pochihh/MAE_162_2026/mechanical/README.md

# Mechanical Design

CAD files for the robot chassis and manipulator systems.
