pochihh/MAE_162_2026/docs/README.md

# Documentation

Assembly instructions, course materials, and technical documentation.

## Contents

### Assembly Guides
- PCB assembly instructions
- Mechanical assembly steps
- Wiring diagrams and connection guides
- Initial setup and calibration procedures

### Course Materials
- Lab exercises and tutorials
- Programming examples
- Troubleshooting guides
- Theory and background materials

### Technical Documentation
- Hardware interface specifications
- Software API documentation
- Safety guidelines

## Format

Documents should be:
- Student-friendly with clear diagrams and photos
- Version-controlled (prefer Markdown when possible)
- Tested by having students follow instructions
