pochihh/MAE_162_2026/NUEVO board/schematic/SCH_Schematic1_2026-02-13.pdf

# Power Input

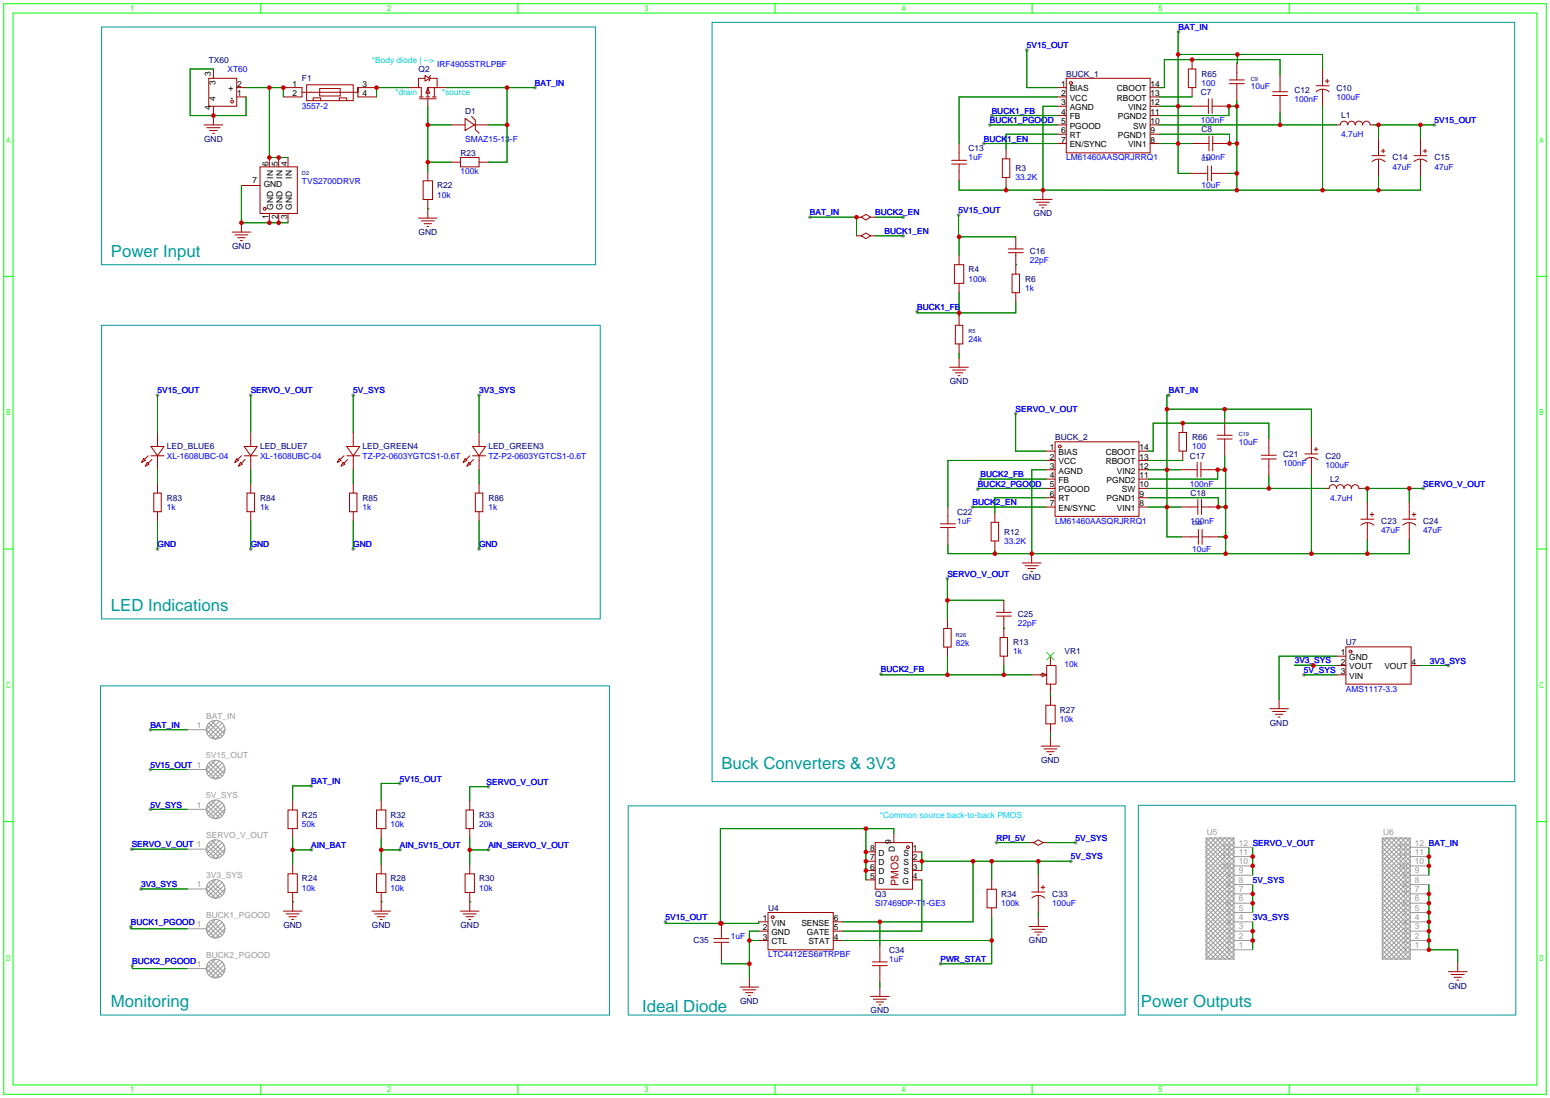
[picture p1: page 1]

*Common source back-to-back PMOS

Power Outputs Ideal Diode

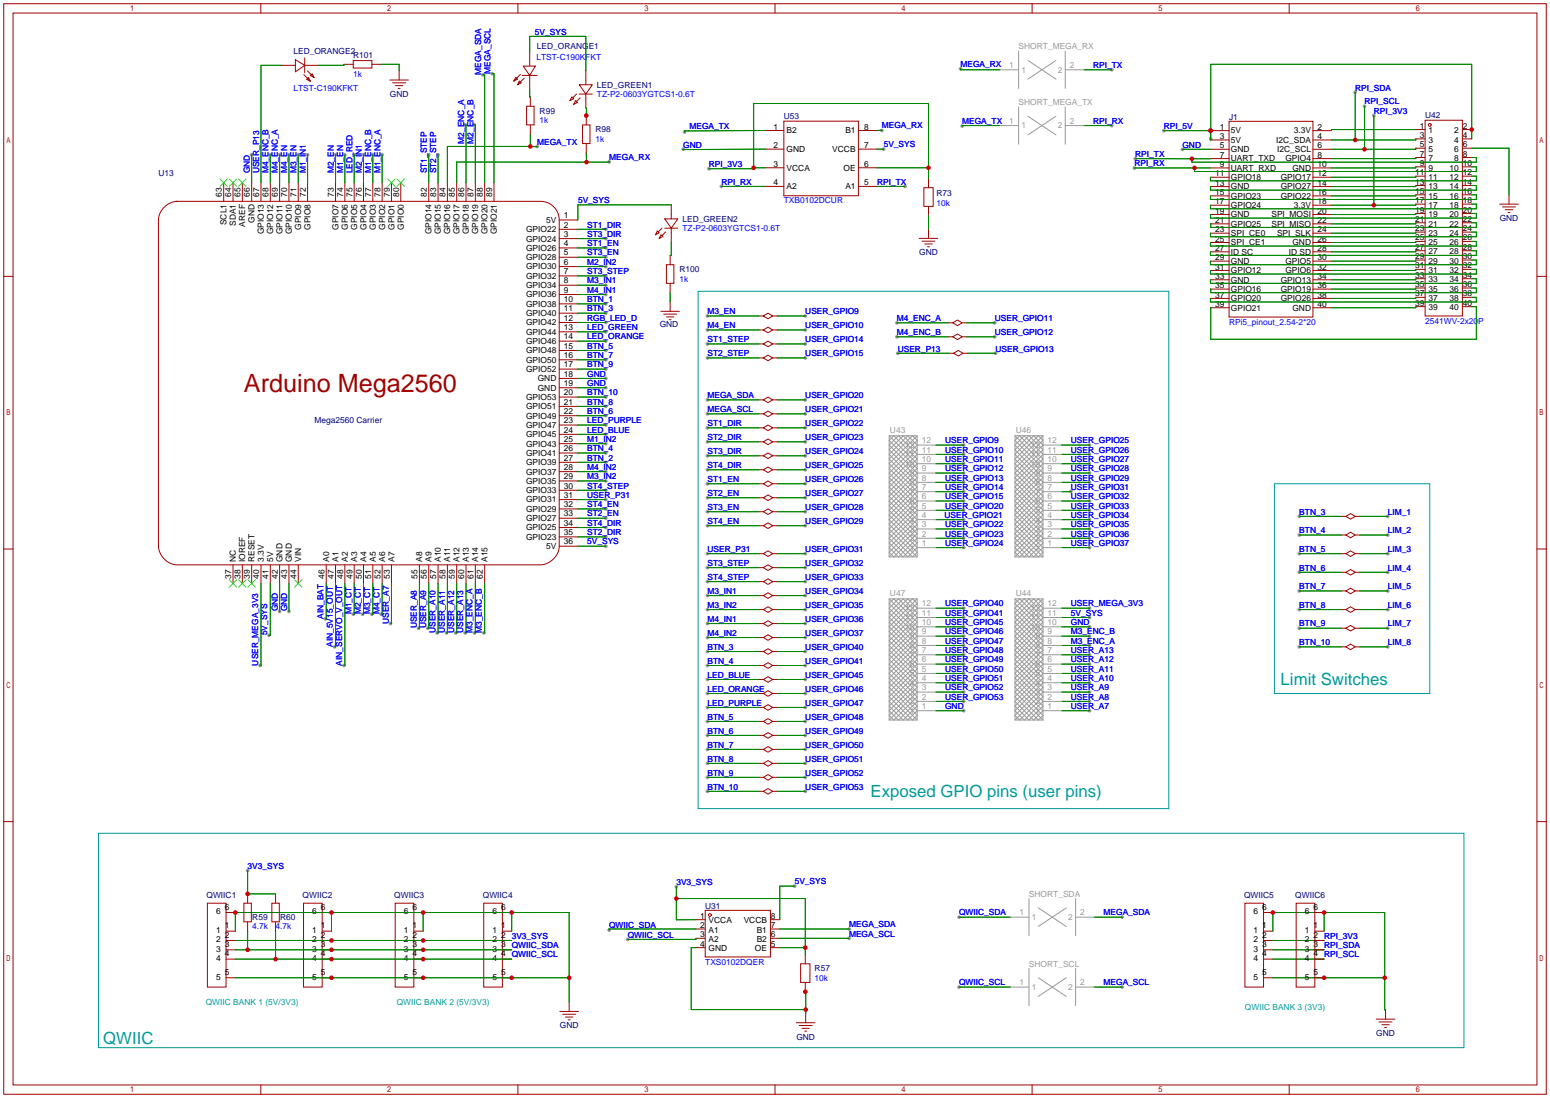
[picture p2: page 2]

Exposed GPIO pins (user pins)

# Dual H-Bridge

# Dual H-Bridge

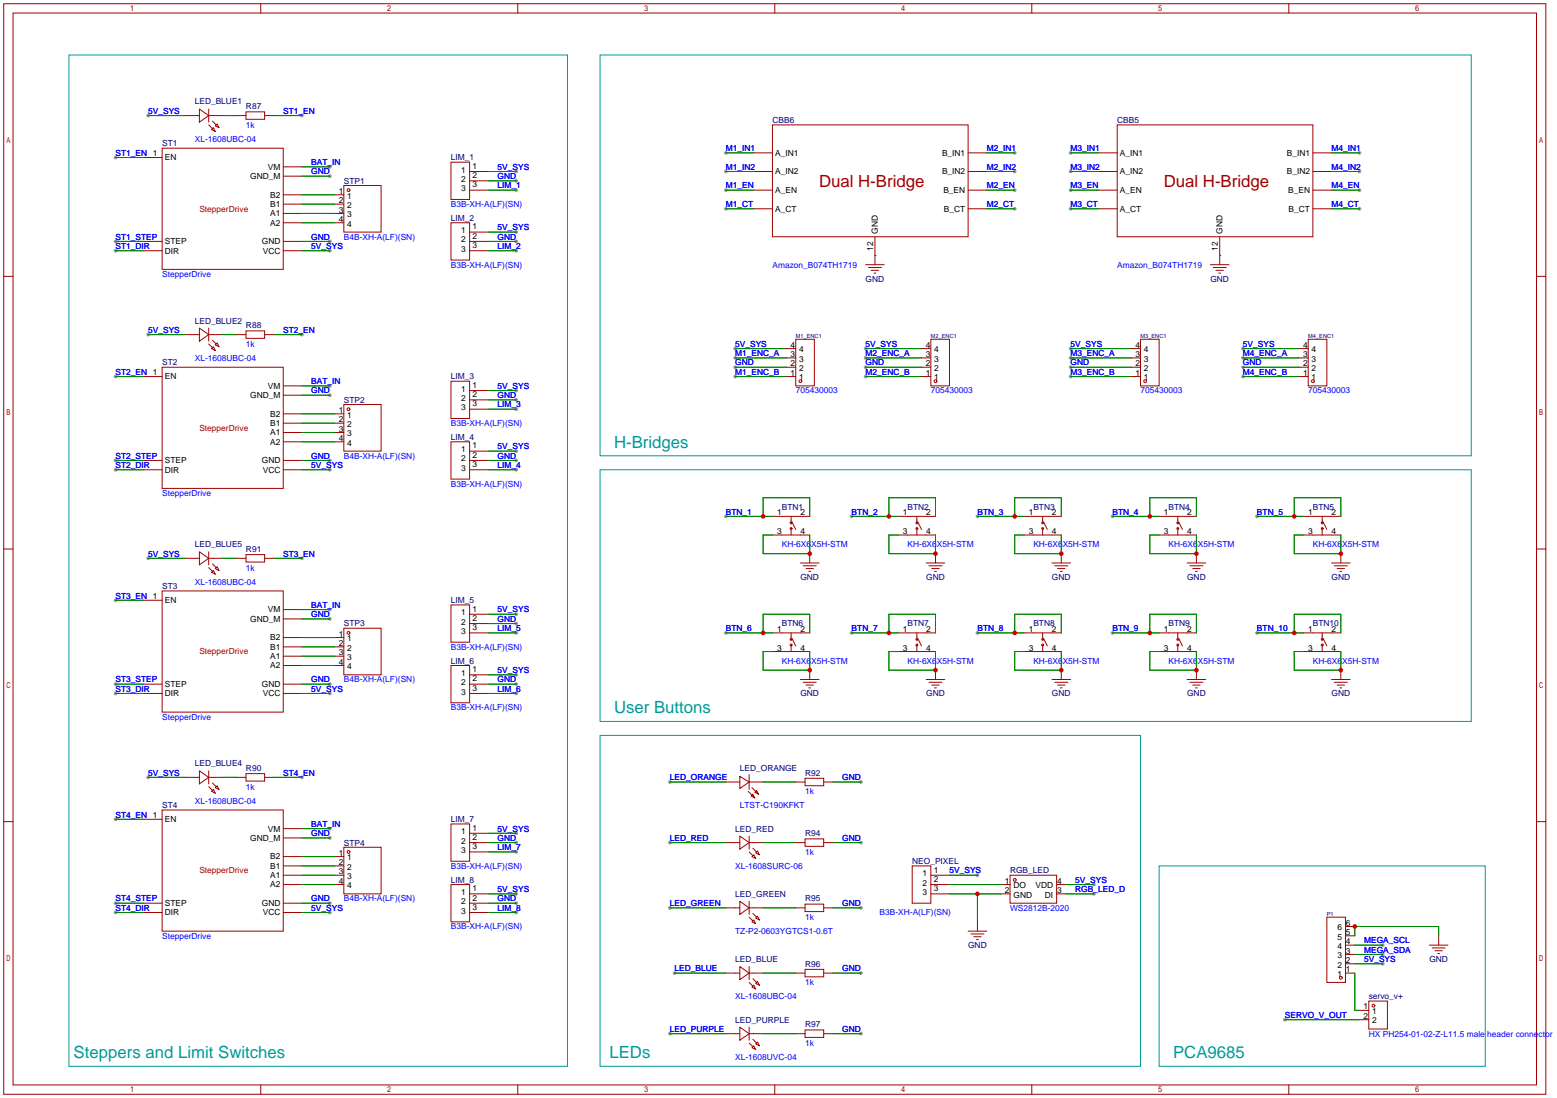
[picture p3: page 3]

Steppers and Limit Switches

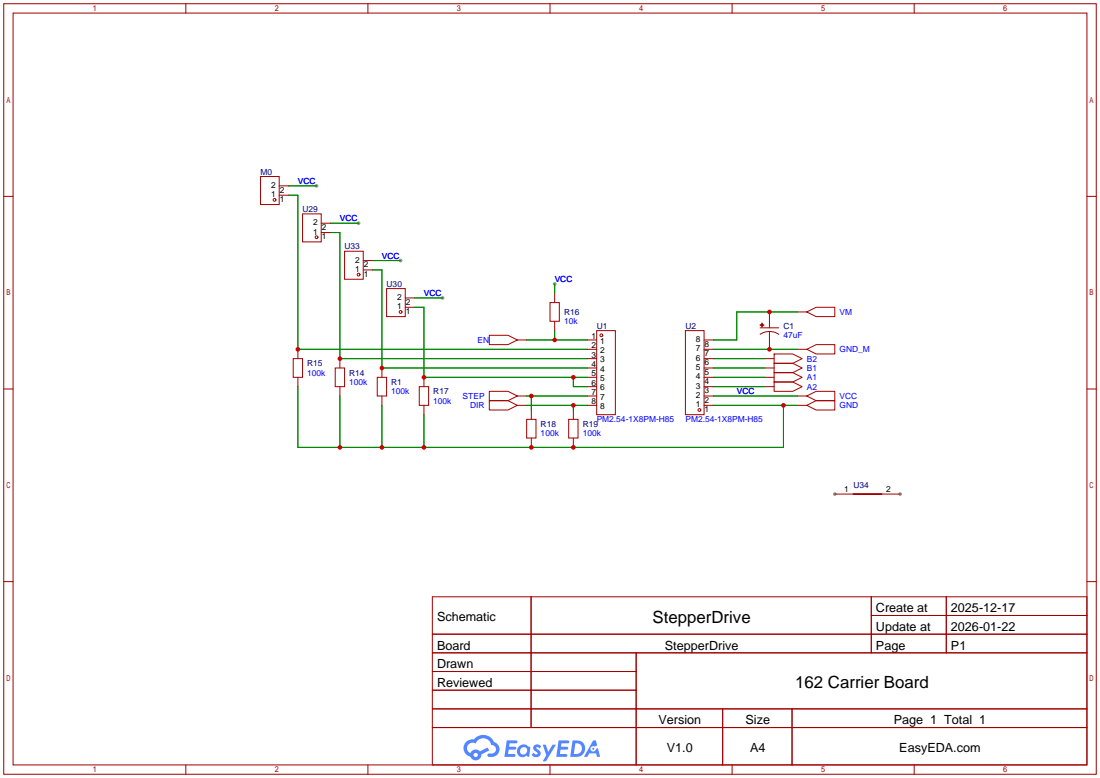
[picture p4: page 4]

Schematic | StepperDrive | Create at | 2025-12-17

Update at | 2026-01-22

Board | StepperDrive | Page | P1
Drawn | | 162 Carrier Board
Reviewed

Version | Size | Page 1 Total 1
V1.0 | A4 | EasyEDA.com

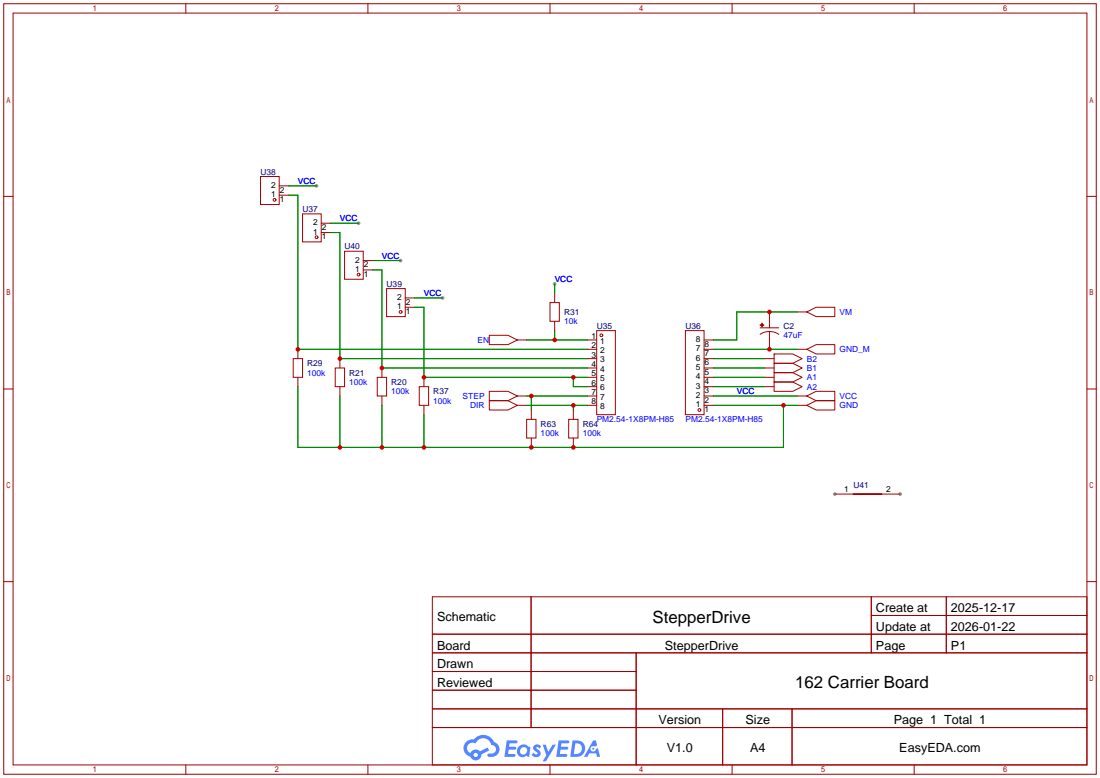
[picture p5: page 5]

Schematic | StepperDrive | Create at | 2025-12-17

Update at | 2026-01-22

Board | StepperDrive | Page | P1
Drawn | | 162 Carrier Board
Reviewed

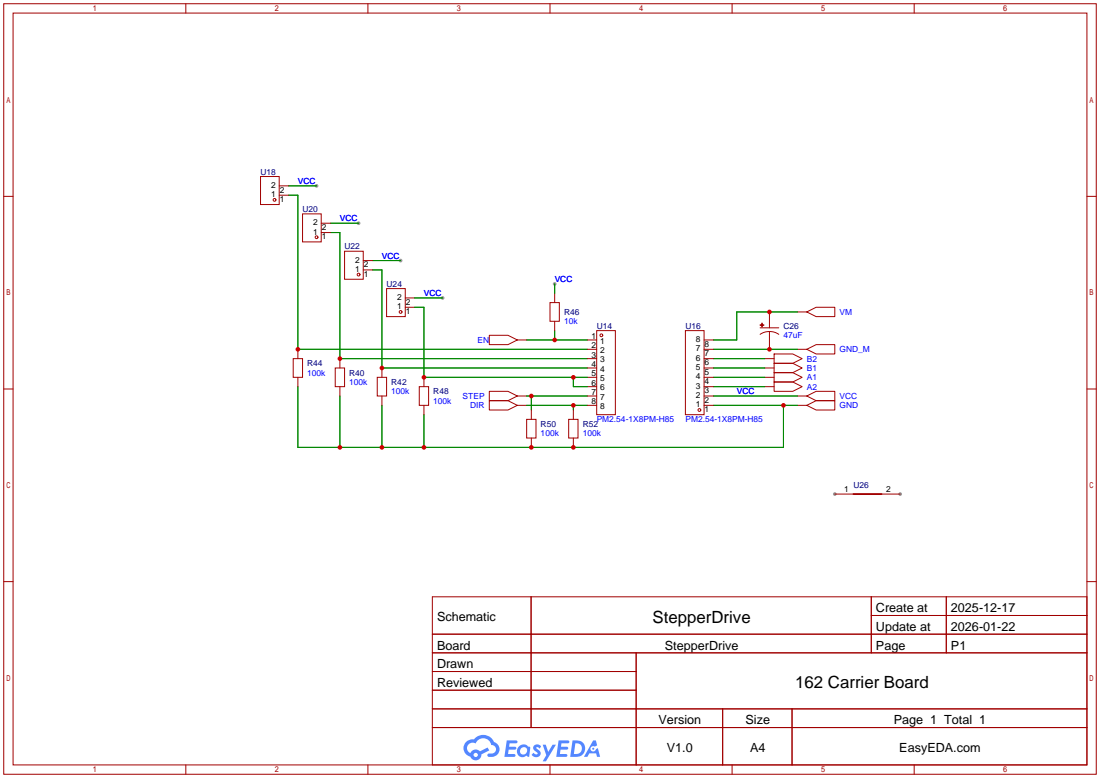
[picture p6: page 6]

Schematic | StepperDrive | Create at | 2025-12-17

Update at | 2026-01-22

Board | StepperDrive | Page | P1
Drawn | | 162 Carrier Board
Reviewed

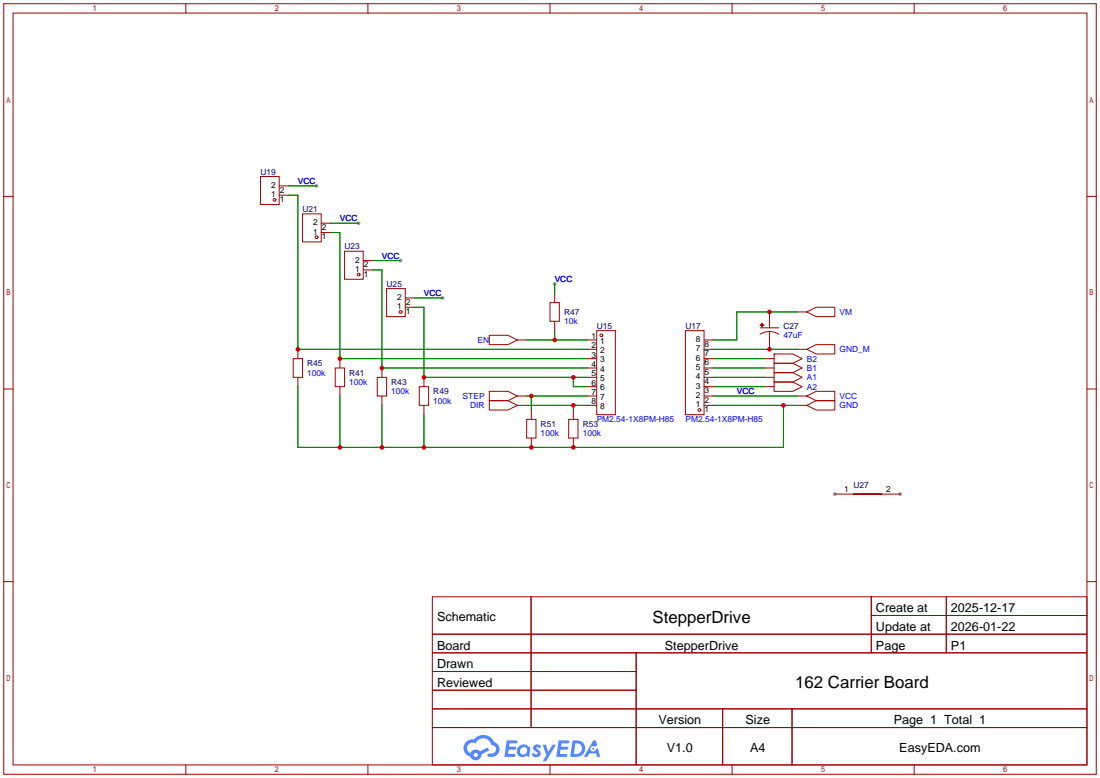
[picture p7: page 7]

Schematic | StepperDrive | Create at | 2025-12-17

Update at | 2026-01-22

Board | StepperDrive | Page | P1
Drawn | | 162 Carrier Board
Reviewed

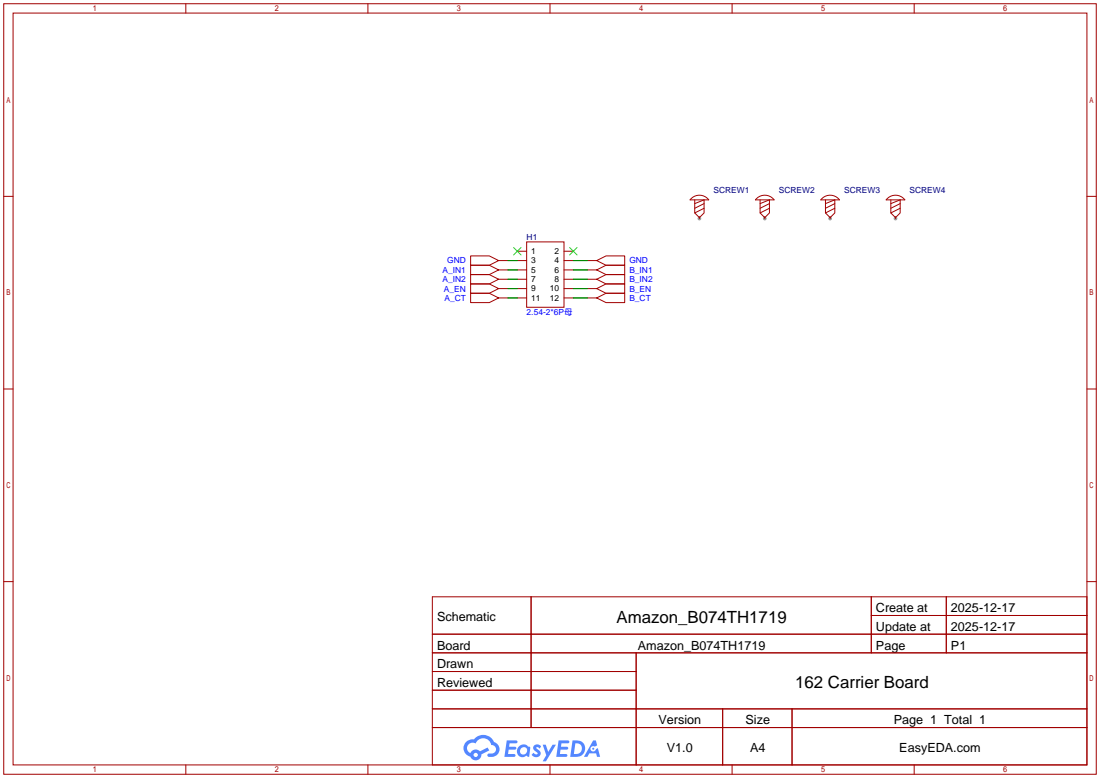
[picture p8: page 8]

Schematic | Amazon_B074TH1719 | Create at | 2025-12-17

Update at | 2025-12-17

Board | Amazon_B074TH1719 | Page | P1
Drawn | | 162 Carrier Board
Reviewed

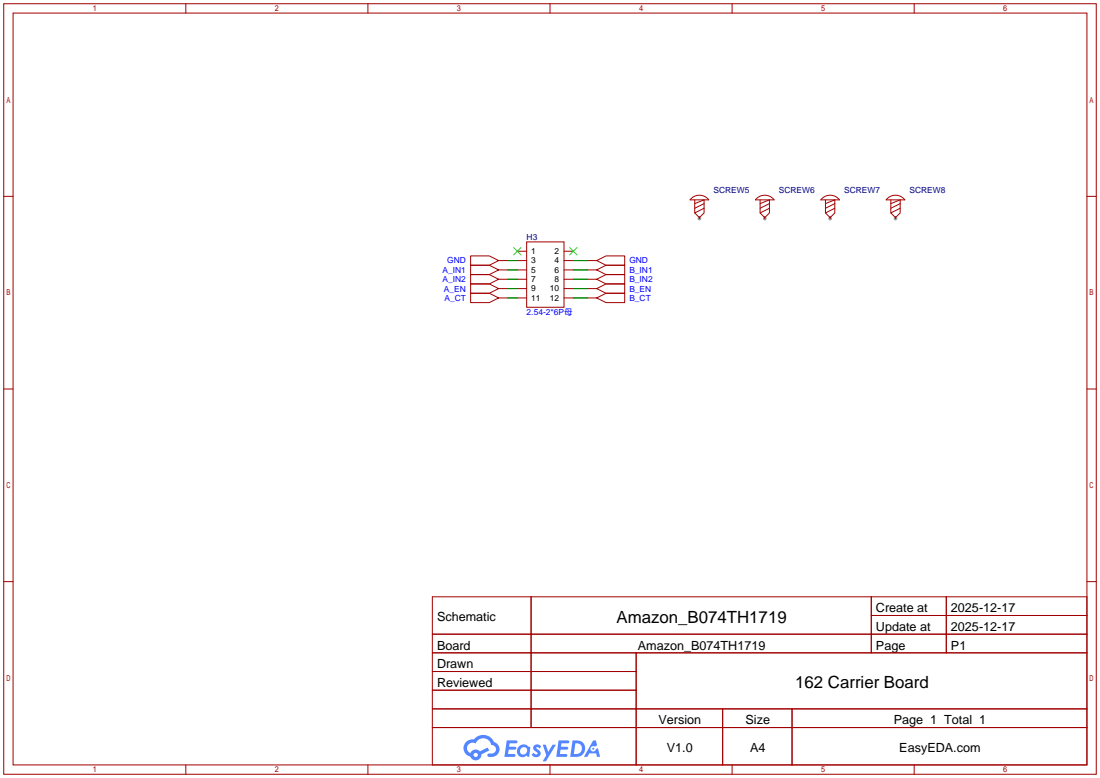
[picture p9: page 9]

Schematic | Amazon_B074TH1719 | Create at | 2025-12-17

Update at | 2025-12-17

Board | Amazon_B074TH1719 | Page | P1
Drawn | | 162 Carrier Board
Reviewed
