pochihh/MAE_162_2026/(list of files, drawings)

Other design files:
NUEVO board/project/NUEVO board Rev. B.epro
