pochihh/MAE_162_2026/firmware/arduino/PCA9685_compile.cpp

/**
 * @file PCA9685_compile.cpp
 * @brief Arduino IDE compilation wrapper for PCA9685 library
 *
 * This file includes the PCA9685 library source to ensure it's compiled
 * with the Arduino sketch. Arduino IDE doesn't automatically compile
 * .cpp files in subdirectories other than src/.
 */

#include "lib/PCA9685.cpp"
