pochihh/MAE_162_2026/(commit log)

2026-01-24 Added NUEVO board
    [BOM_Carrier_1_PCB1_1_2025-12-22.xlsx]
2026-01-28 udated python UART test code
2026-01-28 updated UART python test code
2026-02-14 updated PCB design and documentations
    [BOM_Carrier_1_PCB1_1_2025-12-22.xlsx, NUEVO board Rev. B.epro, ProPrj_162 Carrier Board_2026-02-10.epro]
2026-04-17 tighten mag calibration quality gates for noisy environments
    - MIN_DURATION_S 6s → 12s to force longer data collection
    - MAX_STD_RATIO 0.75 → 0.55, TIMEOUT_STD_RATIO 0.90 → 0.75
    - Require span stability (5s no growth) before early acceptance
    - Activates the previously unused SPAN_GROWTH_EPS_UT tracking
